jblang/SN76489/SN76489.pdf

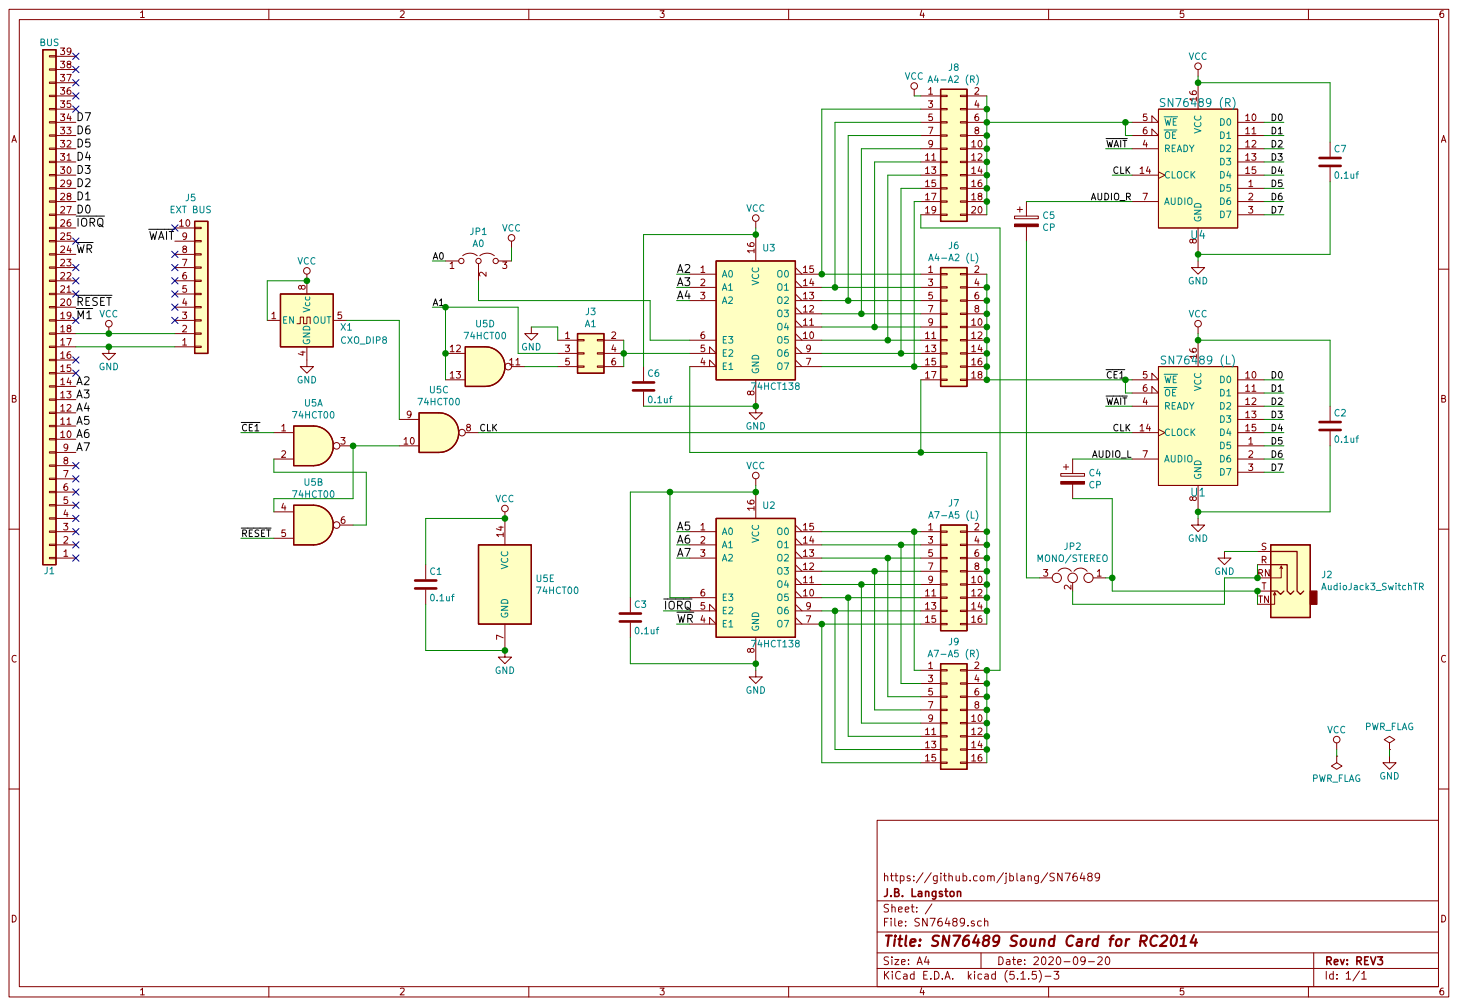
[picture p2: page 1]

11 | 12
13 | 14
15 | 16

IORQ | | | 13 | 14

File: SN76489.sch Sheet: / J.B. Langston

Id: 1/1 Title: SN76489 Sound Card for RC2014
