jblang/SN76489/(threads)

Thread 3 (2021-11-24):

INFO: connect /WAIT signal

sandman72, 2021-11-24:
Just a quick note for RC2014 Classic users (40pin bus): You will need to connect the /WAIT signal directly to your CPU modules /WAIT pin in order to get the SN76489 board working correctly. Took me a while to figure out, as a lot of other sources declare it optional... ;)

Great work JB!

Thread 4 (2022-04-19):

Gerber files

patracy, 2022-04-19:
URL to Gerber files seems to be broken

xanthoes, 2022-12-11:
Still broken... :-(
