jblang/SN76489/(commit log)

2018-10-26 Additional tweaks
    [SN76489.kicad_pcb, SN76489.sch]
2018-10-30 Add footprint for CUI audio jack
    [SN76489.kicad_pcb, SN76489.sch]
2018-11-22 Update readme with BOM and additional instructions
2020-09-13 Add local oscillator and startup quiet circuitry; switch to same capacitor footprint as z80ctrl
    [SN76489.kicad_pcb, SN76489.sch]
2020-09-13 Fix board outline, final REV2 tweaks
    [SN76489.kicad_pcb, SN76489.sch]
2020-09-20 Fix address decoding mistakes for REV3
    [SN76489.kicad_pcb, SN76489.sch]
2020-09-27 Final REV3 tweaks
    [SN76489.kicad_pcb]
2020-10-05 Update PDF schematic for REV3
2020-10-10 I'm an idiot... fix floating A0/A1 lines for REV4
    [SN76489.kicad_pcb, SN76489.sch]
2020-10-11 Final REV4 tweaks
    [SN76489.kicad_pcb, SN76489.sch]
2022-10-22 Upgrade Kicad projects to v6
    [SN76489.kicad_pcb, SN76489.kicad_sch, SN76489.sch]
