jblang/SN76489/(notices)

Notices in the files:
SN76489.kicad_pcb:
Copyright (C)2020 J.B. Langston
